Dixit-Golakiya/Master-Thesis-Project/Hardware/KiCad/Super_Capacitor_measurement1.png

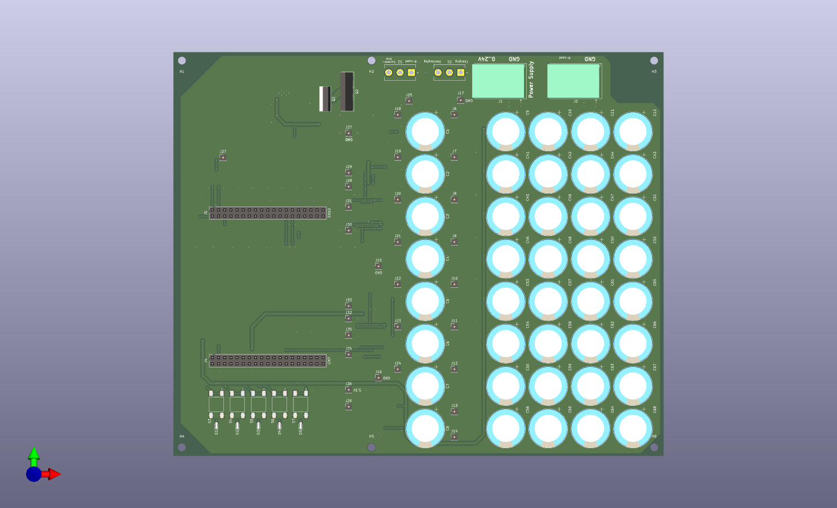
Hardware/KiCad/Super_Capacitor_measurement1.png
