Dixit-Golakiya/Master-Thesis-Project/Hardware/KiCad/Super_Capacitor_measurement2.png

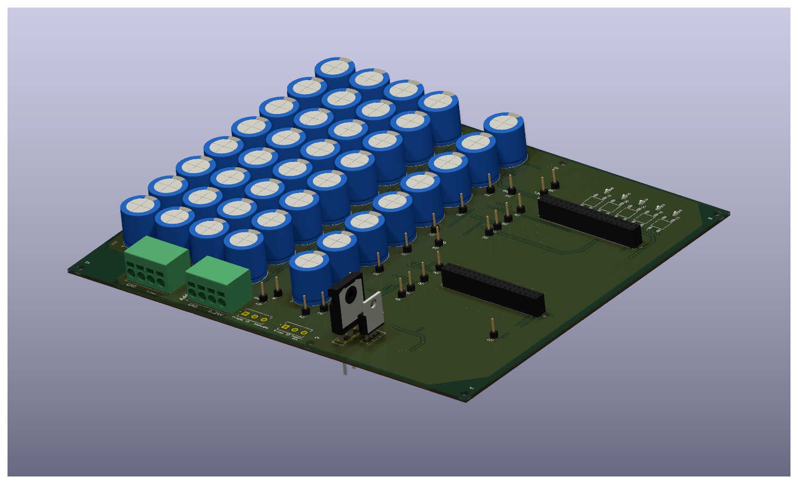
Hardware/KiCad/Super_Capacitor_measurement2.png
