Dixit-Golakiya/Master-Thesis-Project/Hardware/KiCad/Super_Capacitor_measurement3.png

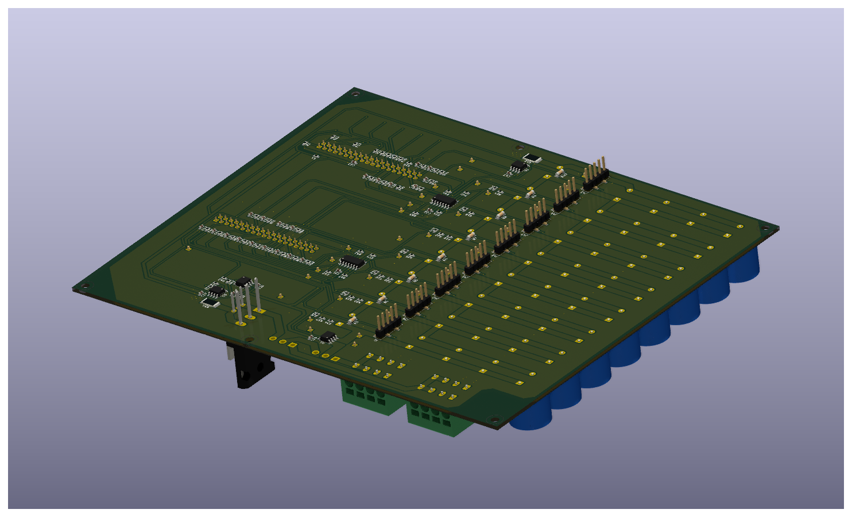
Hardware/KiCad/Super_Capacitor_measurement3.png
