Dixit-Golakiya/Master-Thesis-Project/Hardware/KiCad/Super_Capacitor_measurement.png

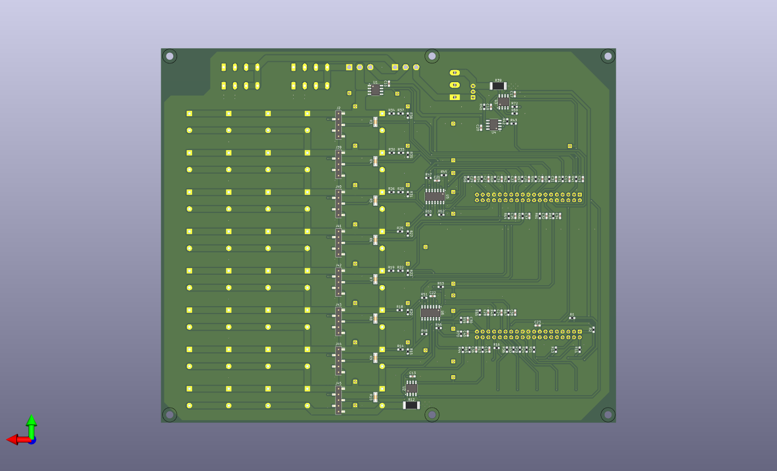
Hardware/KiCad/Super_Capacitor_measurement.png
