Dixit-Golakiya/Master-Thesis-Project/Figure/A_Super_Capacitor_measurement.pdf

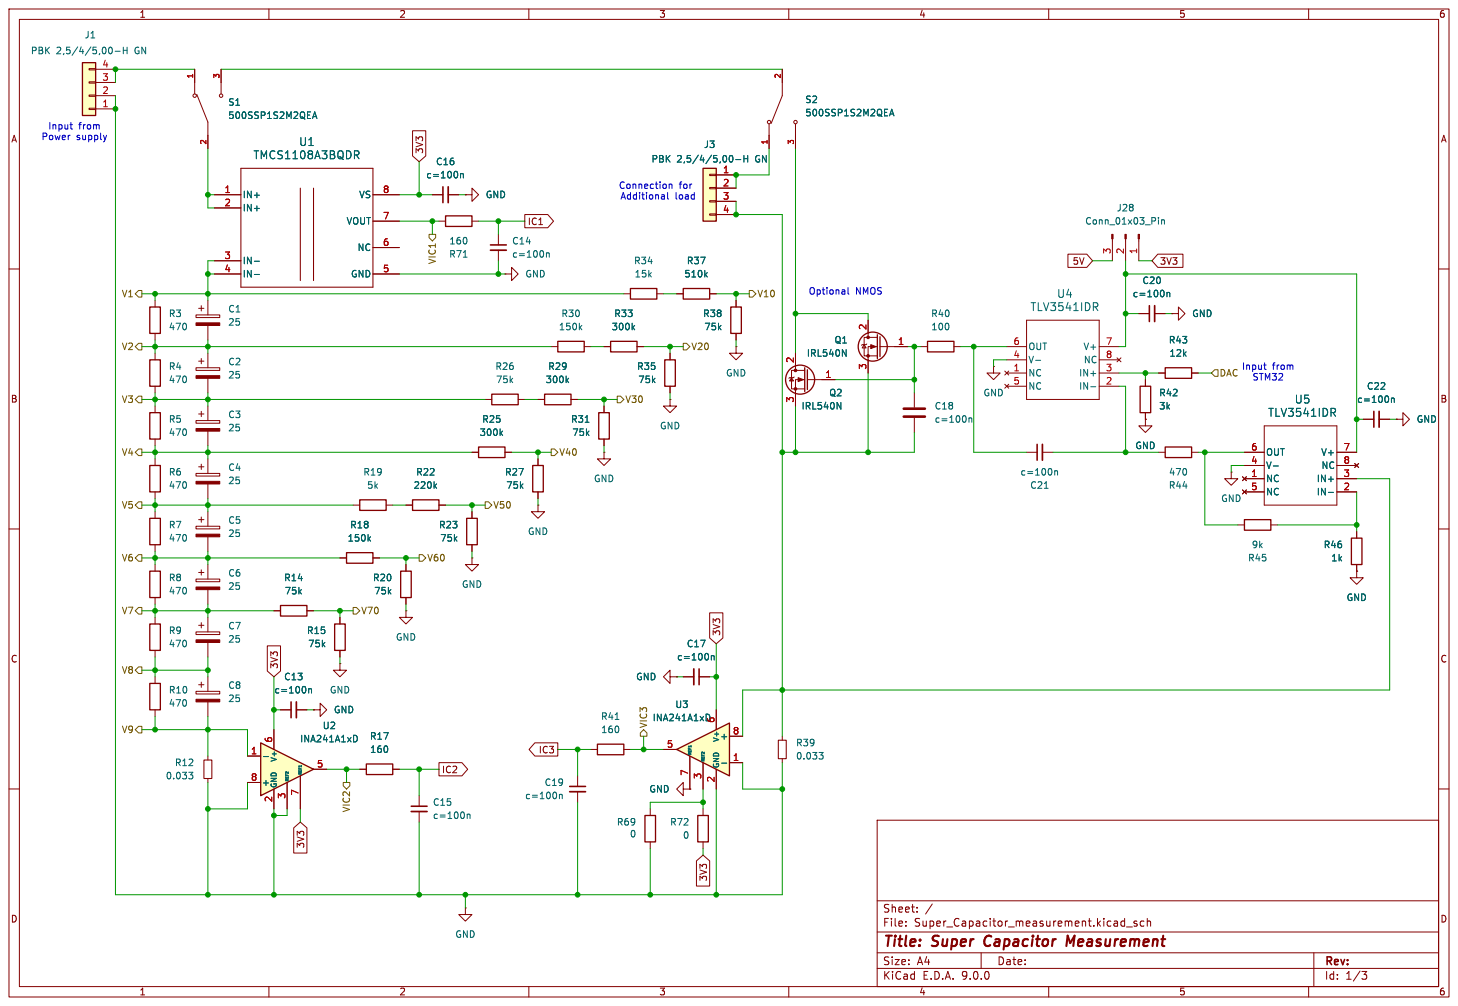
[picture p9: page 1]

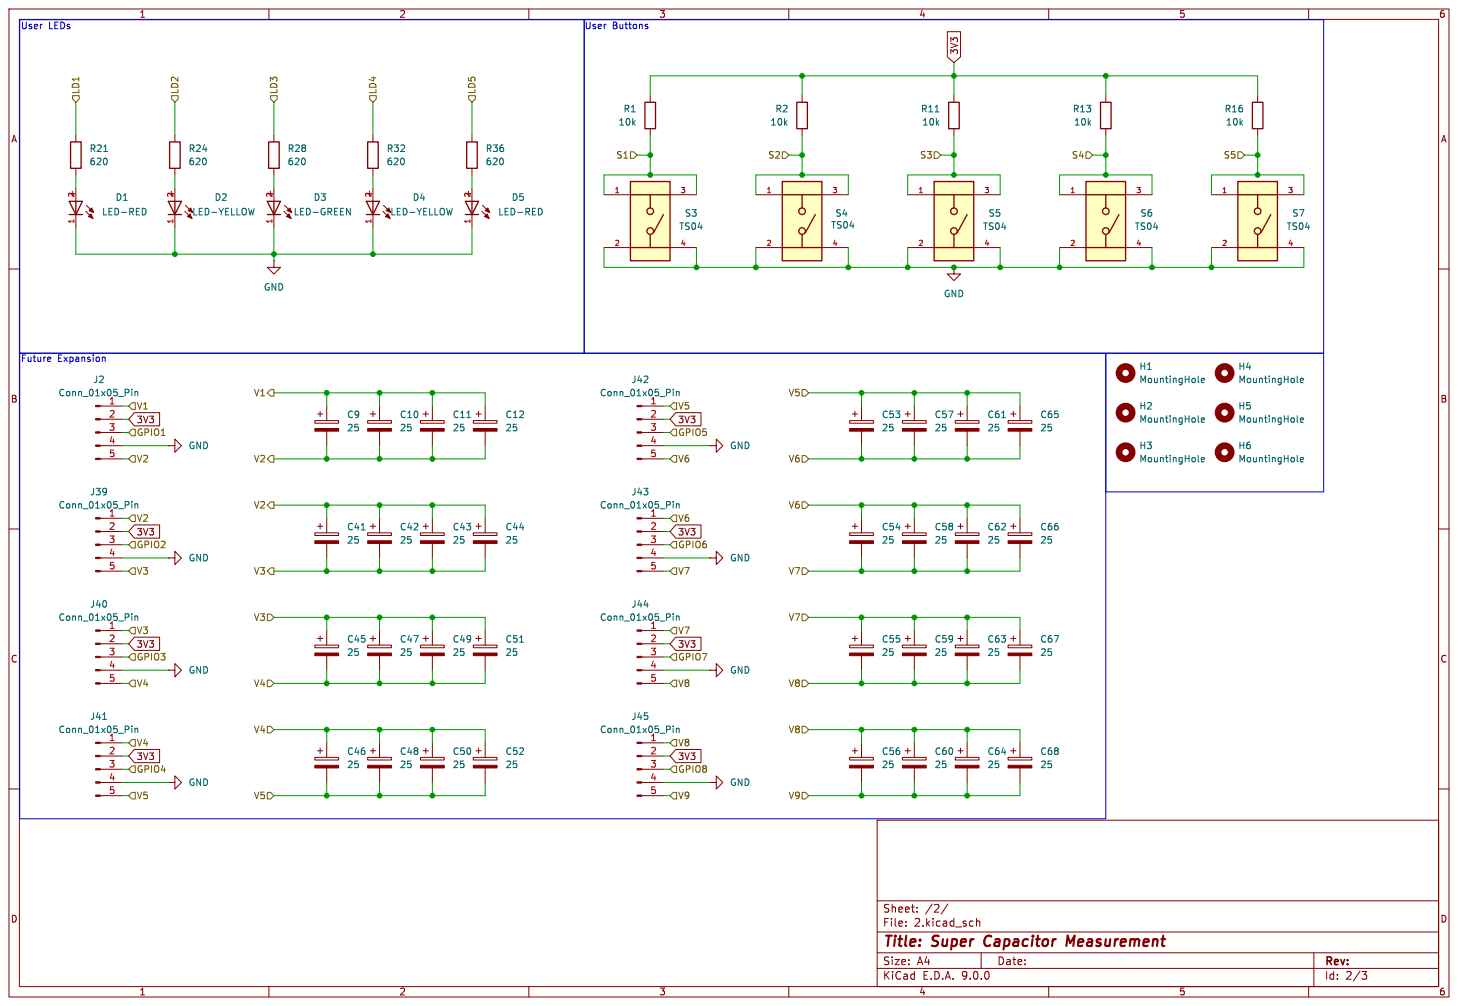
[picture p10: page 2]

Id: 2/3 Title: Super Capacitor Measurement File: 2.kicad_sch Sheet: /2/ GND

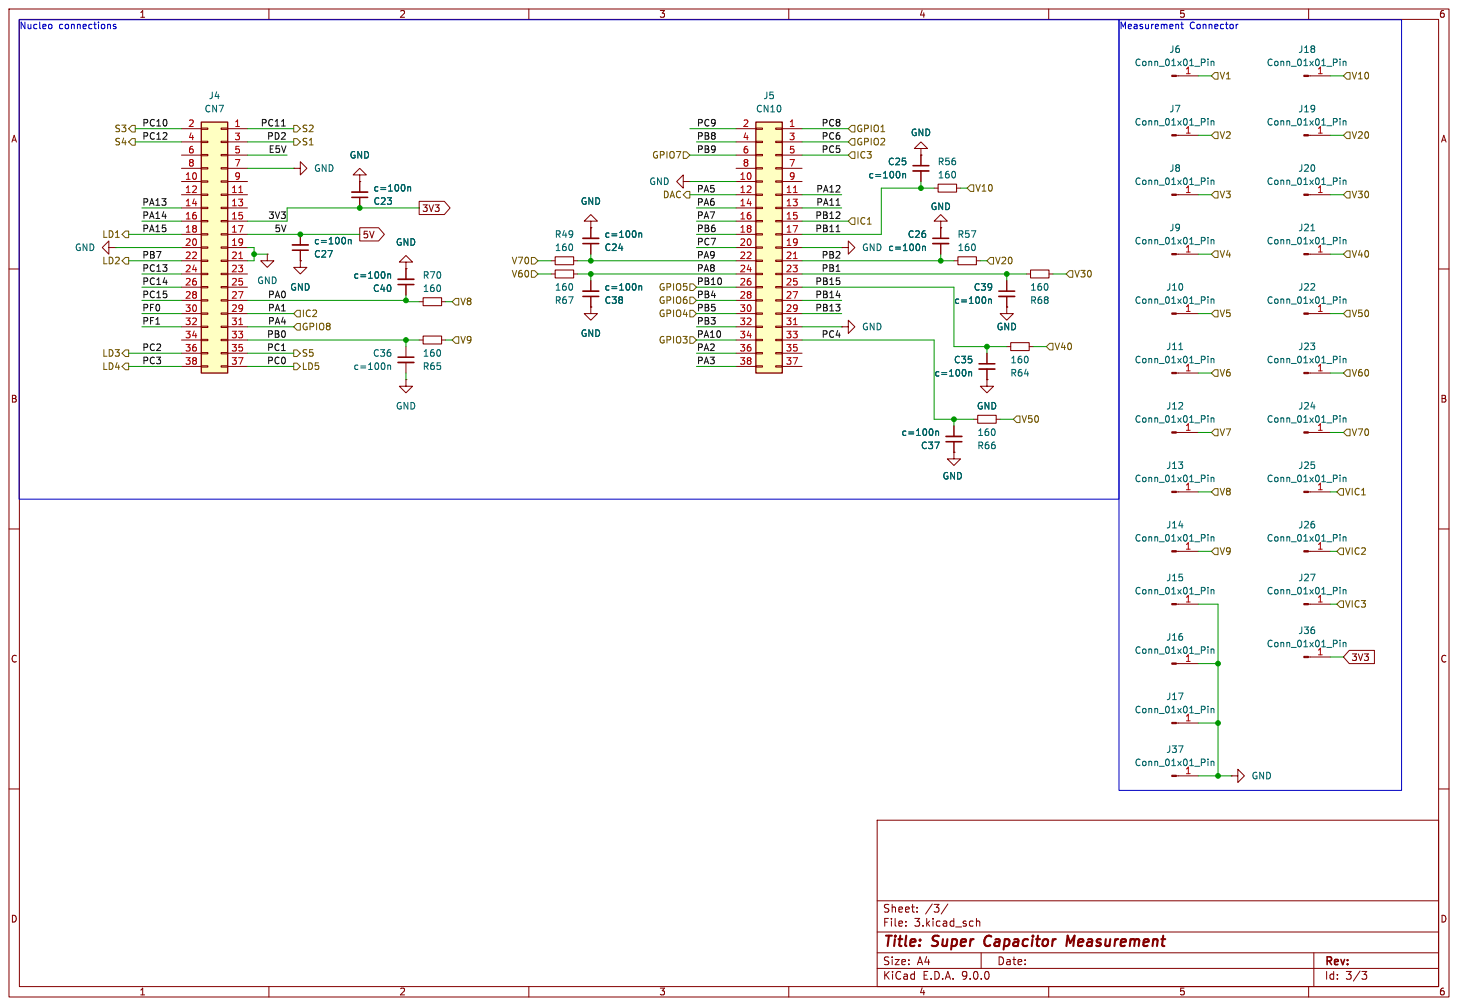
[picture p11: page 3]

Id: 3/3 Title: Super Capacitor Measurement File: 3.kicad_sch Sheet: /3/
