Dixit-Golakiya/Master-Thesis-Project/Figure/B_1_Super_Capacitor_measurement-F_Cu.pdf

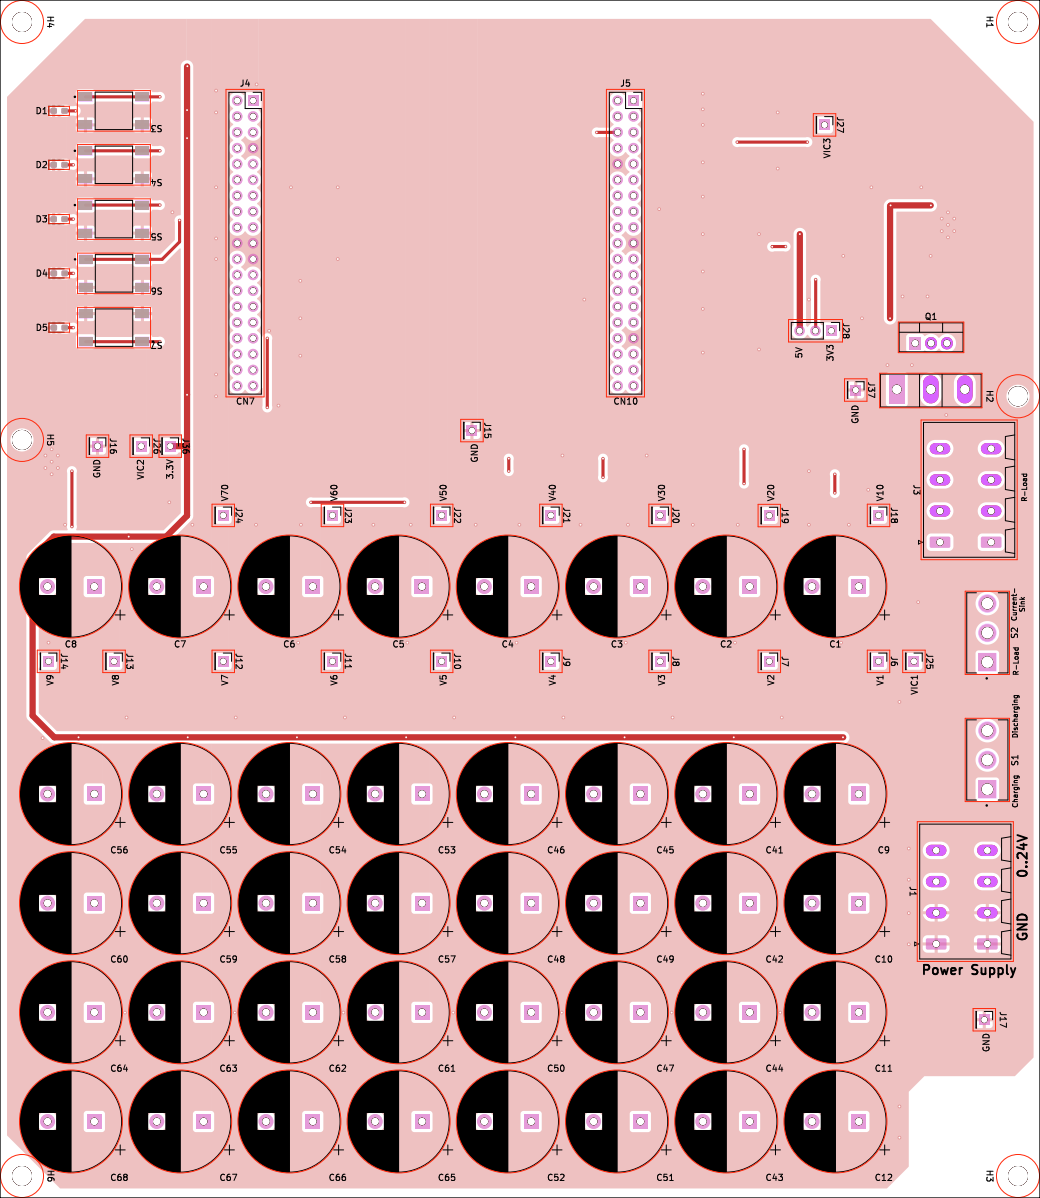
[picture p12: page 1]
