Dixit-Golakiya/Master-Thesis-Project/Figure/B_2_Super_Capacitor_measurement-B_Cu.pdf

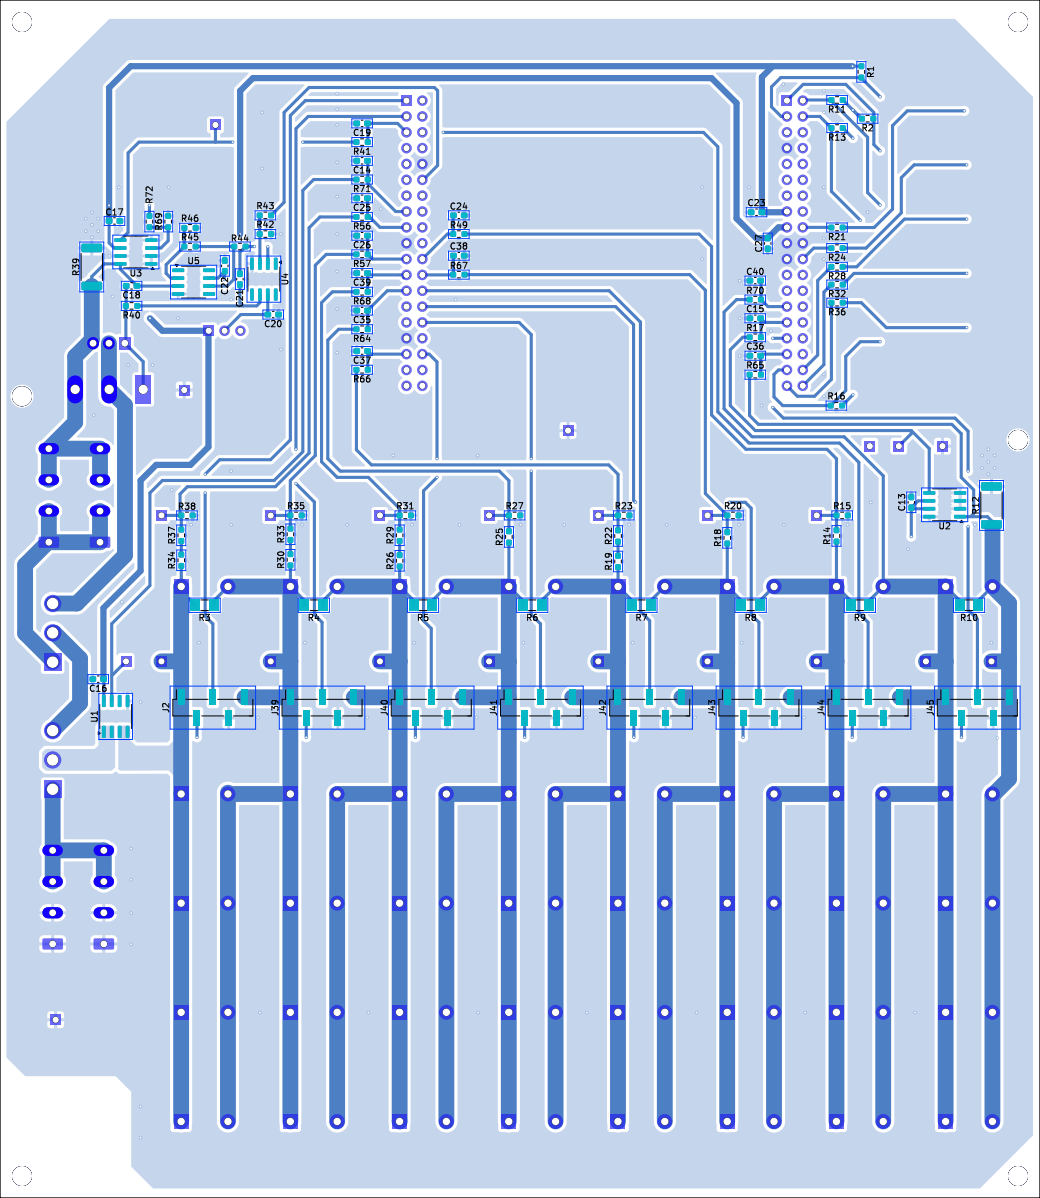
[picture p13: page 1]
