Dixit-Golakiya/Master-Thesis-Project/Simulation/LTSpice/Capacitor_Measurement.asc

B1: bi; I=(V(i1)-1.64979)/0.2
B2: bi; I=(V(i2)-1.64979)/(20*0.033)
B3: bi; I=(V(i3)-1.64979)/(20*0.033)
C1: cap; 25; Rser=0.034
C2: cap; 25; Rser=0.034
C3: cap; 25; Rser=0.034
C4: cap; 25; Rser=0.034
C5: cap; 25; Rser=0.034
C6: cap; 25; Rser=0.034
C7: cap; 25; Rser=0.034
C8: cap; 25; Rser=0.034
C9: cap; 25; Rser=0.034
C10: cap; 25; Rser=0.034
C11: cap; 25; Rser=0.034
C12: cap; 25; Rser=0.034
C13: cap; 25; Rser=0.034
C14: cap; 25; Rser=0.034
C15: cap; 25; Rser=0.034
C16: cap; 25; Rser=0.034
C17: cap; 25; Rser=0.034
C18: cap; 25; Rser=0.034
C19: cap; 25; Rser=0.034
C20: cap; 25; Rser=0.034
C21: cap; 25; Rser=0.034
C22: cap; 25; Rser=0.034
C23: cap; 25; Rser=0.034
C24: cap; 25; Rser=0.034
C25: cap; 25; Rser=0.034
C26: cap; 25; Rser=0.034
C27: cap; 25; Rser=0.034
C28: cap; 25; Rser=0.034
C29: cap; 25; Rser=0.034
C30: cap; 25; Rser=0.034
C31: cap; 25; Rser=0.034
C32: cap; 25; Rser=0.034
C33: cap; 25; Rser=0.034
C34: cap; 25; Rser=0.034
C35: cap; 25; Rser=0.034
C36: cap; 25; Rser=0.034
C37: cap; 25; Rser=0.034
C38: cap; 25; Rser=0.034
C39: cap; 25; Rser=0.034
C40: cap; 25; Rser=0.034
C41: cap; 100n
C42: cap; 100n
C43: cap; 100n
C44: cap; 100n
C45: cap; 100n
I1: current; PULSE(0 2 0 1e-6 1e-6 16 16 1)
R1: res2; 470; tol=1
R2: res2; 470; tol=1
R3: res2; 470; tol=1
R4: res2; 470; tol=1
R5: res2; 470; tol=1
R6: res2; 470; tol=1
R7: res2; 470; tol=1
R8: res2; 470; tol=1
R9: res2; 0.033; tol=1
R10: res2; 0.033; tol=1
R11: res2; 100; tol=1
R12: res2; 3k; tol=1
R13: res2; 12k; tol=1
R14: res2; 470; tol=1
R15: res2; 9k; tol=1
R16: res2; 1k; tol=1
R17: res; 160
R18: res2; 160; tol=1
R19: res2; 160; tol=1
U1: irl540ns
U2: TLV354
U3: TLV354
U4: TMCS1108A3B
U5: INA241A2
U6: INA241A2
V1: voltage; 3.3
V3: voltage; PULSE(0 3.3 25 1e-9 1e-9 4 4 1)
V4: voltage; 5
Named nets: 0, 3V3, DAC, 5V, V1, V2, V3, V4, V5, V6, V7, V8, V9, I1, I2, I3, CS+, CS-, V+
.tran 0 45 0
.ic V(V1)=18.0128
.options abstol=1n reltol=0.01 vntol=1m noopiter
Current Sink
Power Supply
Current Measurement
Capacitor Bank
