Dixit-Golakiya/Master-Thesis-Project/Hardware/KiCad/Super_Capacitor_measurement.kicad_pcb

## KiCad design Hardware/KiCad/Super_Capacitor_measurement.kicad_pcb (2026-07-08)

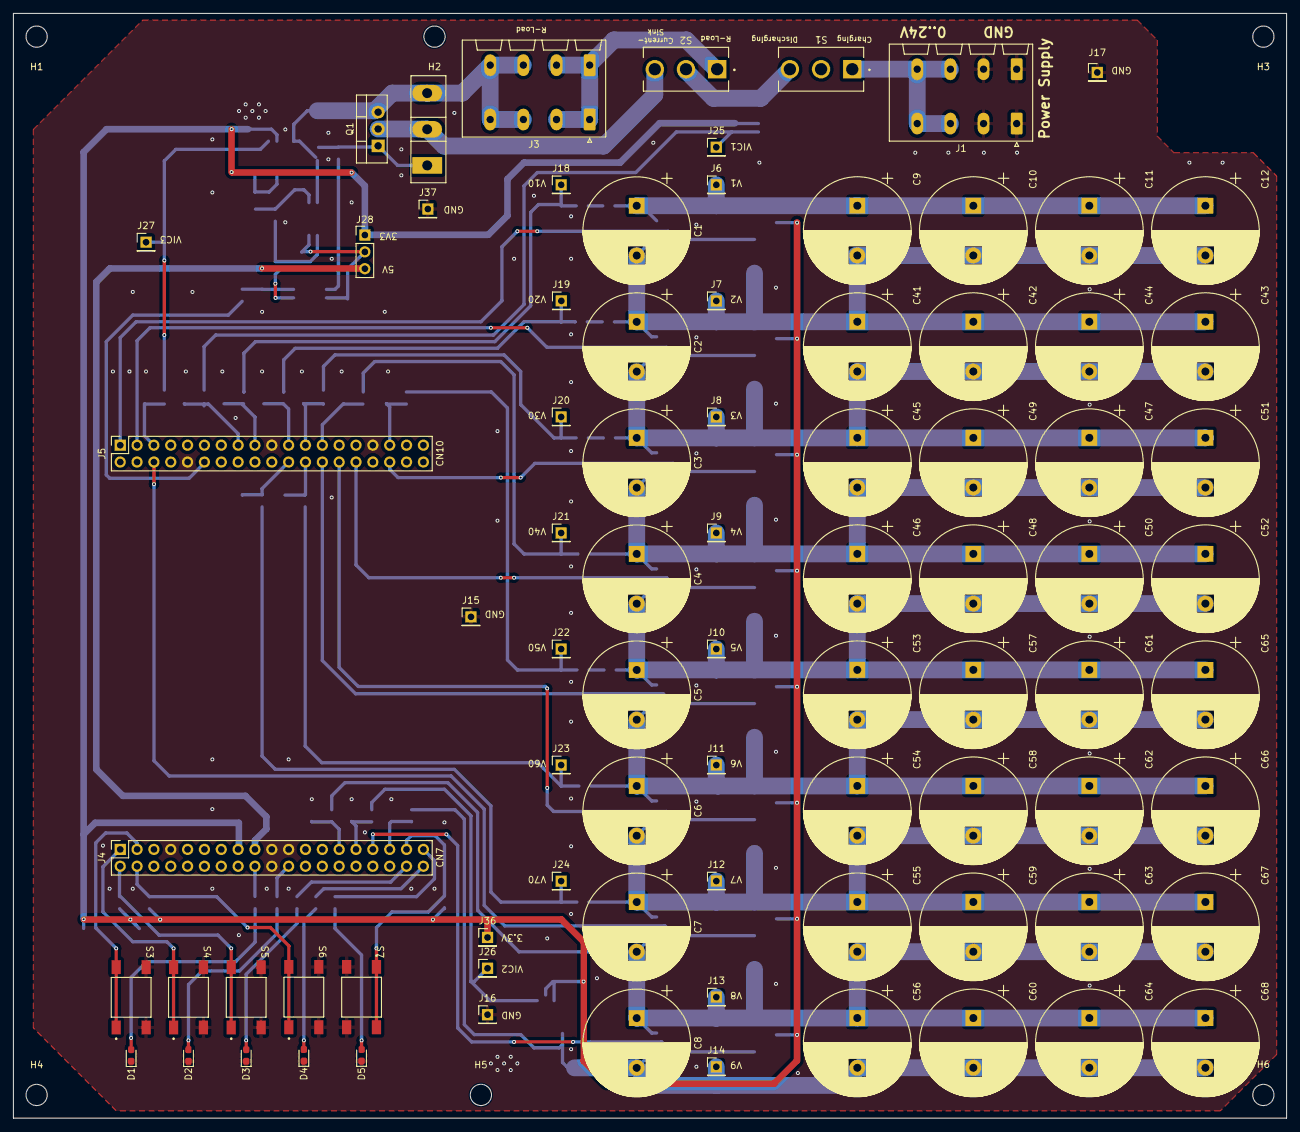
[picture p14: board Super_Capacitor_measurement.kicad_pcb from above]

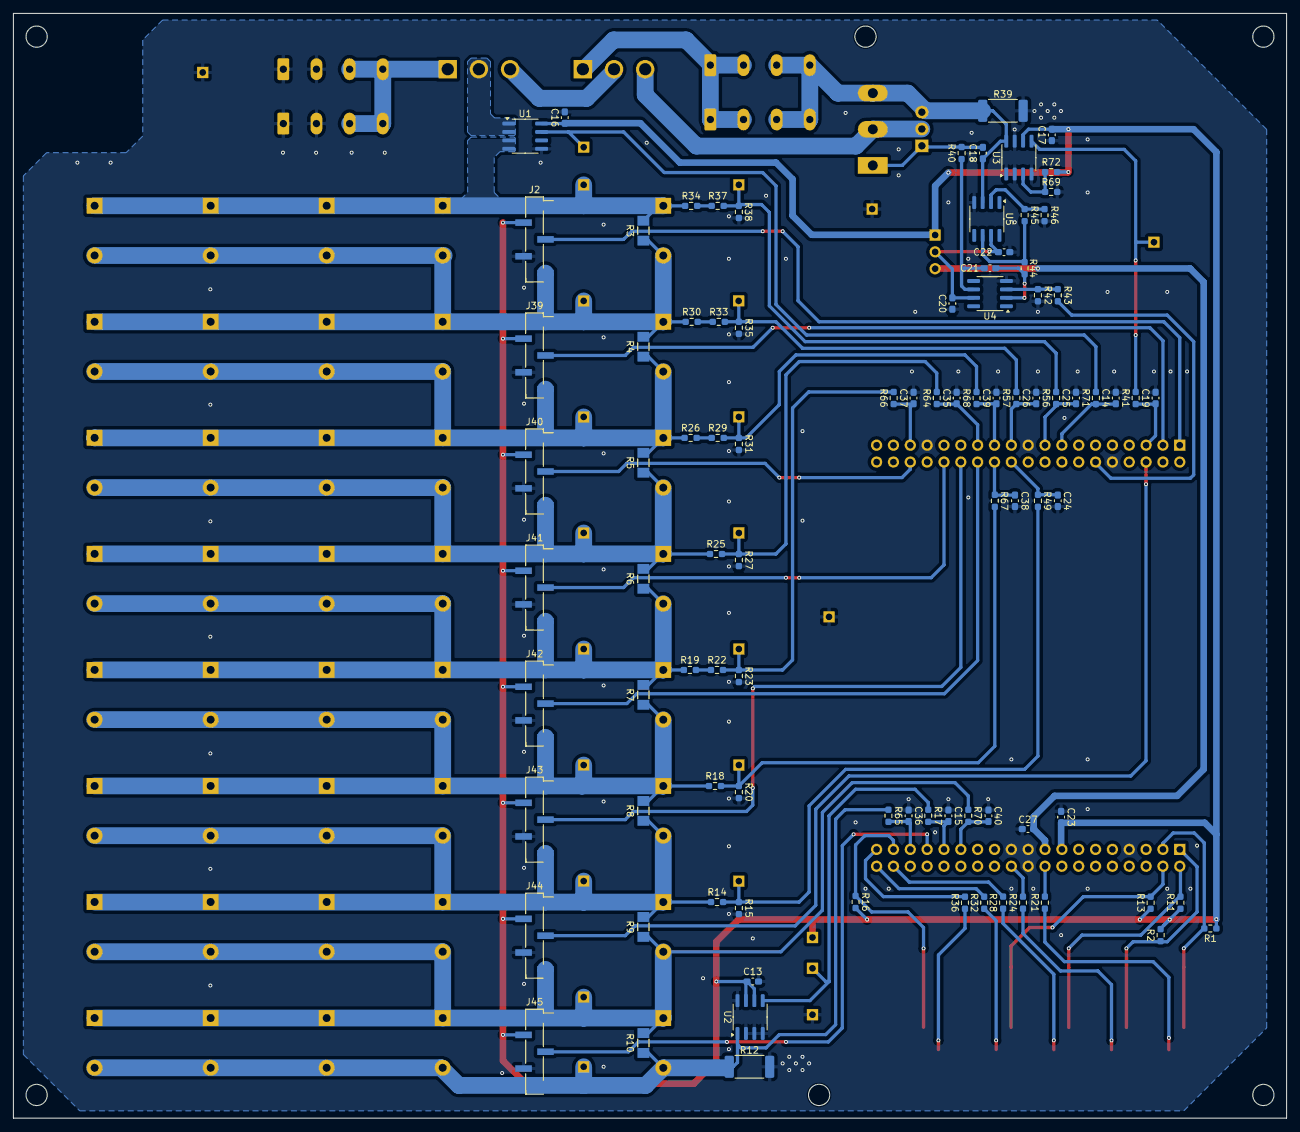
[picture p15: board Super_Capacitor_measurement.kicad_pcb from below]

Board: 2 copper layers, 192.0 x 166.6 mm, 181 parts (92 on the bottom side), 76 nets.

Parts:
C1, C2, C3, C4, C5, C6, C7, C8, C9, C10, C11, C12, C41, C42, C43, C44, C45, C46, C47, C48, C49, C50, C51, C52, C53, C54, C55, C56, C57, C58, C59, C60, C61, C62, C63, C64, C65, C66, C67, C68: 25; CP_Radial_D16.0mm_P7.50mm
C13, C14, C15, C16, C17, C18, C19, C20, C21, C22, C23, C24, C25, C26, C27, C35, C36, C37, C38, C39, C40: c=100n; C_0603_1608Metric_Pad1.08x0.95mm_HandSolder
D1, D3: LED-GREEN; LED_0603_1608Metric_Pad1.05x0.95mm_HandSolder
D2, D4: LED-YELLOW; LED_0603_1608Metric_Pad1.05x0.95mm_HandSolder
D5: LED-RED; LED_0603_1608Metric_Pad1.05x0.95mm_HandSolder
H1, H2, H3, H4, H5, H6: MountingHole; MountingHole_3.2mm_M3
J1, J3: PBK 2,5/4/5,00-H GN; PhoenixContact_SPT_2.5_4-H-5.0_1x04_P5.0mm_Horizontal
J2, J39, J40, J41, J42, J43, J44, J45: Conn_01x05_Pin; PinHeader_1x05_P2.54mm_Vertical_SMD_Pin1Right
J4: CN7; PinSocket_2x19_P2.54mm_Vertical
J5: CN10; PinSocket_2x19_P2.54mm_Vertical
J6, J7, J8, J9, J10, J11, J12, J13, J14, J15, J16, J17, J18, J19, J20, J21, J22, J23, J24, J25, J26, J27, J36, J37: Conn_01x01_Pin; PinHeader_1x01_P2.54mm_Vertical
J28: Conn_01x03_Pin; PinHeader_1x03_P2.54mm_Vertical
Q1: IRL540N; TO-220-3_Vertical
Q2: IRL540N; TO-247-3_Vertical
R1, R2, R11, R13, R16: 10k; R_0603_1608Metric_Pad0.98x0.95mm_HandSolder
R3, R4, R5, R6, R7, R8, R9, R10: 510; R_MiniMELF_MMA-0204
R12, R39: 0.033; R_2512_6332Metric_Pad1.40x3.35mm_HandSolder
R14, R15, R20, R23, R26, R27, R31, R35, R38: 75k; R_0603_1608Metric_Pad0.98x0.95mm_HandSolder
R17, R41, R49, R56, R57, R64, R65, R66, R67, R68, R70, R71: 160; R_0603_1608Metric_Pad0.98x0.95mm_HandSolder
R18, R30: 150k; R_0603_1608Metric_Pad0.98x0.95mm_HandSolder
R19: 5k; R_0603_1608Metric_Pad0.98x0.95mm_HandSolder
R21, R24, R28, R32, R36: 620; R_0603_1608Metric_Pad0.98x0.95mm_HandSolder
R22: 220k; R_0603_1608Metric_Pad0.98x0.95mm_HandSolder
R25, R29, R33: 300k; R_0603_1608Metric_Pad0.98x0.95mm_HandSolder
R34: 15k; R_0603_1608Metric_Pad0.98x0.95mm_HandSolder
R37: 510k; R_0603_1608Metric_Pad0.98x0.95mm_HandSolder
R40: 100; R_0603_1608Metric_Pad0.98x0.95mm_HandSolder
R42: 3k; R_0603_1608Metric_Pad0.98x0.95mm_HandSolder
R43: 12k; R_0603_1608Metric_Pad0.98x0.95mm_HandSolder
R44: 470; R_0603_1608Metric_Pad0.98x0.95mm_HandSolder
R45: 9k; R_0603_1608Metric_Pad0.98x0.95mm_HandSolder
R46: 1k; R_0603_1608Metric_Pad0.98x0.95mm_HandSolder
R69, R72: 0; R_0603_1608Metric_Pad0.98x0.95mm_HandSolder
S1, S2: 500SSP1S2M2QEA; SW_500SSP1S2M2QEA
S3, S4, S5, S6, S7: TS04; SW_TS04
U1: TMCS1108A3UQDR; SOIC-8_3.9x4.9mm_P1.27mm
U2, U3: INA241A1xD; SOIC-8_3.9x4.9mm_P1.27mm
U4, U5: TLV3541IDR; SOIC-8_3.9x4.9mm_P1.27mm

Connections:
3V3: C13.1, C16.1, C17.1, C23.1, J2.2, J4.15, J28.1, J36.1, J39.2, J40.2, J41.2, J42.2, J43.2, J44.2, J45.2, R1.2, R2.2, R11.2, R13.2, R16.2, R72.2, U1.8 (VS), U2.6 (V+), U2.7 (REF1), U3.6 (V+)
5V: C27.2, J4.17, J28.3
/PA0: C40.1, J4.27, R70.1
/PA4: J4.31, J45.3
/PA5: J5.12, R43.1
/PA8: C38.2, J5.24, R67.1
/PA9: C24.1, J5.22, R49.1
/PA10: J5.34, J40.3
/PA15: J4.18, R21.2
/PB0: C36.1, J4.33, R65.1
/PB1: C39.1, J5.23, R68.1
/PB2: C26.2, J5.21, R57.1
/PB4: J5.28, J43.3
/PB5: J5.30, J41.3
/PB7: J4.22, R24.2
/PB9: J5.6, J44.3
/PB10: J5.26, J42.3
/PB11: C25.2, J5.17, R56.2
/PB15: C35.1, J5.25, R64.1
/PC0: J4.37, R36.2
/PC1: J4.35, R16.1, S7.1, S7.3
/PC2: J4.36, R28.2
/PC3: J4.38, R32.2
/PC4: C37.2, J5.33, R66.1
/PC6: J5.3, J39.3
/PC8: J2.3, J5.1
/PC10: J4.2, R11.1, S5.1, S5.3
/PC11: J4.1, R2.1, S4.1, S4.3
/PC12: J4.4, R13.1, S6.1, S6.3
/PD2: J4.3, R1.1, S3.1, S3.3
/V1: C1.1, C9.1, C10.1, C11.1, C12.1, J2.1, J6.1, R3.1, R34.1, U1.3 (IN-), U1.4 (IN-)
/V2: C1.2, C2.1, C9.2, C10.2, C11.2, C12.2, C41.1, C42.1, C43.1, C44.1, J2.5, J7.1, J39.1, R3.2, R4.1, R30.1
/V3: C2.2, C3.1, C41.2, C42.2, C43.2, C44.2, C45.1, C47.1, C49.1, C51.1, J8.1, J39.5, J40.1, R4.2, R5.1, R26.1
/V4: C3.2, C4.1, C45.2, C46.1, C47.2, C48.1, C49.2, C50.1, C51.2, C52.1, J9.1, J40.5, J41.1, R5.2, R6.1, R25.1
/V5: C4.2, C5.1, C46.2, C48.2, C50.2, C52.2, C53.1, C57.1, C61.1, C65.1, J10.1, J41.5, J42.1, R6.2, R7.1, R19.2
/V6: C5.2, C6.1, C53.2, C54.1, C57.2, C58.1, C61.2, C62.1, C65.2, C66.1, J11.1, J42.5, J43.1, R7.2, R8.1, R18.1
/V7: C6.2, C7.1, C54.2, C55.1, C58.2, C59.1, C62.2, C63.1, C66.2, C67.1, J12.1, J43.5, J44.1, R8.2, R9.1, R14.1
/V8: C7.2, C8.1, C55.2, C56.1, C59.2, C60.1, C63.2, C64.1, C67.2, C68.1, J13.1, J44.5, J45.1, R9.2, R10.1, R70.2
/V9: C8.2, C56.2, C60.2, C64.2, C68.2, J14.1, J45.5, R10.2, R12.1, R65.2, U2.1 (-)
/V10: J18.1, R37.2, R38.1, R56.1
/V20: J19.1, R33.2, R35.1, R57.2
/V30: J20.1, R29.2, R31.1, R68.2
/V40: J21.1, R25.2, R27.1, R64.2
/V50: J22.1, R22.2, R23.1, R66.2
/V60: J23.1, R18.2, R20.1, R67.2
/V70: J24.1, R14.2, R15.1, R49.2
/VIC1: J25.1, R71.1, U1.7 (VOUT)
/VIC2: J26.1, R17.1, U2.5
/VIC3: J27.1, R41.1, U3.5
GND: C13.2, C14.2, C15.2, C16.2, C17.2, C19.2, C20.2, C22.2, C23.2, C24.2, C25.1, C26.1, C27.1, C35.2, C36.2, C37.1, C38.1, C39.2, C40.2, D1.1, D2.1, D3.1, D4.1, D5.1, J1.1, J1.2, J2.4, J4.7, J4.19, J4.20, J4.21, J5.10, J5.19, J5.31, J15.1, J16.1, J17.1, J37.1, J39.4, J40.4, J41.4, J42.4, J43.4, J44.4, J45.4, R12.2, R15.2, R20.2, R23.2, R27.2, R31.2, R35.2, R38.2, R39.2, R42.1, R46.1, R69.1, S3.2, S3.4, S4.2, S4.4, S5.2, S5.4, S6.2, S6.4, S7.2, S7.4, U1.5 (GND), U2.2 (GND), U2.3 (REF2), U2.4 (GND), U2.8 (+), U3.1 (-), U3.2 (GND), U3.4 (GND), U3.7 (REF1), U4.4 (V-), U5.4 (V-)
IC1: C14.1, J5.15, R71.2
IC2: C15.1, J4.29, R17.2
IC3: C19.1, J5.5, R41.2
unnamed: D1.2, R21.1
unnamed: D2.2, R24.1
unnamed: D3.2, R28.1
unnamed: D4.2, R32.1
unnamed: D5.2, R36.1
unnamed: J1.3, J1.4, S1.1
unnamed: J3.1, J3.2, S2.1
unnamed: C18.2, J3.3, J3.4, Q1.3 (S), Q2.3 (S), R39.1, U3.8 (+), U5.3 (IN+)
unnamed: C20.1, C22.1, J28.2, U4.7 (V+), U5.7 (V+)
unnamed: Q1.2 (D), Q2.2 (D), S2.3
unnamed: C18.1, Q1.1 (G), Q2.1 (G), R40.1
unnamed: R19.1, R22.1
unnamed: R26.2, R29.1
unnamed: R30.2, R33.1
unnamed: R34.2, R37.1
unnamed: S1.2, U1.1 (IN+), U1.2 (IN+)
unnamed: S1.3, S2.2
unnamed: R69.2, R72.1, U3.3 (REF2)
unnamed: R42.2, R43.2, U4.3 (IN+)
unnamed: C21.2, R44.1, U4.2 (IN-)
unnamed: C21.1, R40.2, U4.6 (OUT)
unnamed: R45.2, R46.2, U5.2 (IN-)
unnamed: R44.2, R45.1, U5.6 (OUT)
