Dixit-Golakiya/Master-Thesis-Project/Firmware/STM32/Capacitor_Measurement.ioc

Mcu.UserName=STM32G474RETx
PA0.GPIO_Label=V08
PA0.Signal=ADC1_IN1
PA1.GPIO_Label=IC2
PA1.Signal=ADC1_IN2
PA13.GPIO_Label=T_SWDIO
PA13.Signal=SYS_JTMS-SWDIO
PA14.GPIO_Label=T_SWCLK
PA14.Signal=SYS_JTCK-SWCLK
PA15.GPIO_Label=LD1
PA15.Signal=GPIO_Output
PA2.Signal=USART2_TX
PA5.Signal=COMP_DAC12_group
PA8.GPIO_Label=V60
PA8.Signal=ADC5_IN1
PA9.GPIO_Label=V70
PA9.Signal=ADC5_IN2
PB0.GPIO_Label=V09
PB0.Signal=ADC1_IN15
PB1.GPIO_Label=V30
PB1.Signal=ADC1_IN12
PB11.GPIO_Label=V10
PB11.Signal=ADC1_IN14
PB12.GPIO_Label=IC1
PB12.Signal=ADC1_IN11
PB15.GPIO_Label=V40
PB15.Signal=ADC2_IN15
PB2.GPIO_Label=V20
PB2.Signal=ADC2_IN12
PB3.GPIO_Label=T_SWO
PB3.Signal=SYS_JTDO-SWO
PB4.Signal=USART2_RX
PB7.GPIO_Label=LD2
PB7.Signal=GPIO_Output
PC0.GPIO_Label=LD5
PC0.Signal=GPIO_Output
PC1.GPIO_Label=S5
PC1.Signal=GPXTI1
PC10.GPIO_Label=S3
PC10.Signal=GPXTI10
PC11.GPIO_Label=S2
PC11.Signal=GPXTI11
PC12.GPIO_Label=S4
PC12.Signal=GPXTI12
PC2.GPIO_Label=LD3
PC2.Signal=GPIO_Output
PC3.GPIO_Label=LD4
PC3.Signal=GPIO_Output
PC4.GPIO_Label=V50
PC4.Signal=ADC2_IN5
PC5.GPIO_Label=IC3
PC5.Signal=ADC2_IN11
PD2.GPIO_Label=S1
PD2.Signal=GPXTI2
